INSA-GEI/afficheurs/BatterieMode_Ecran.png

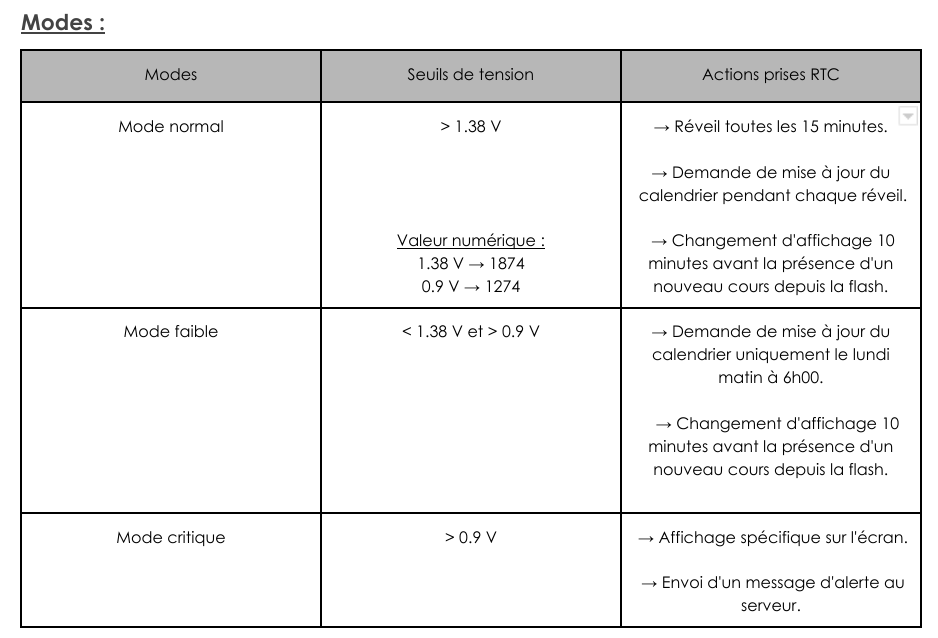
BatterieMode_Ecran.png
