INSA-GEI/afficheurs/Statechart_ecran.pdf

## TASK FIRST WAKE UP

## TASK INIT

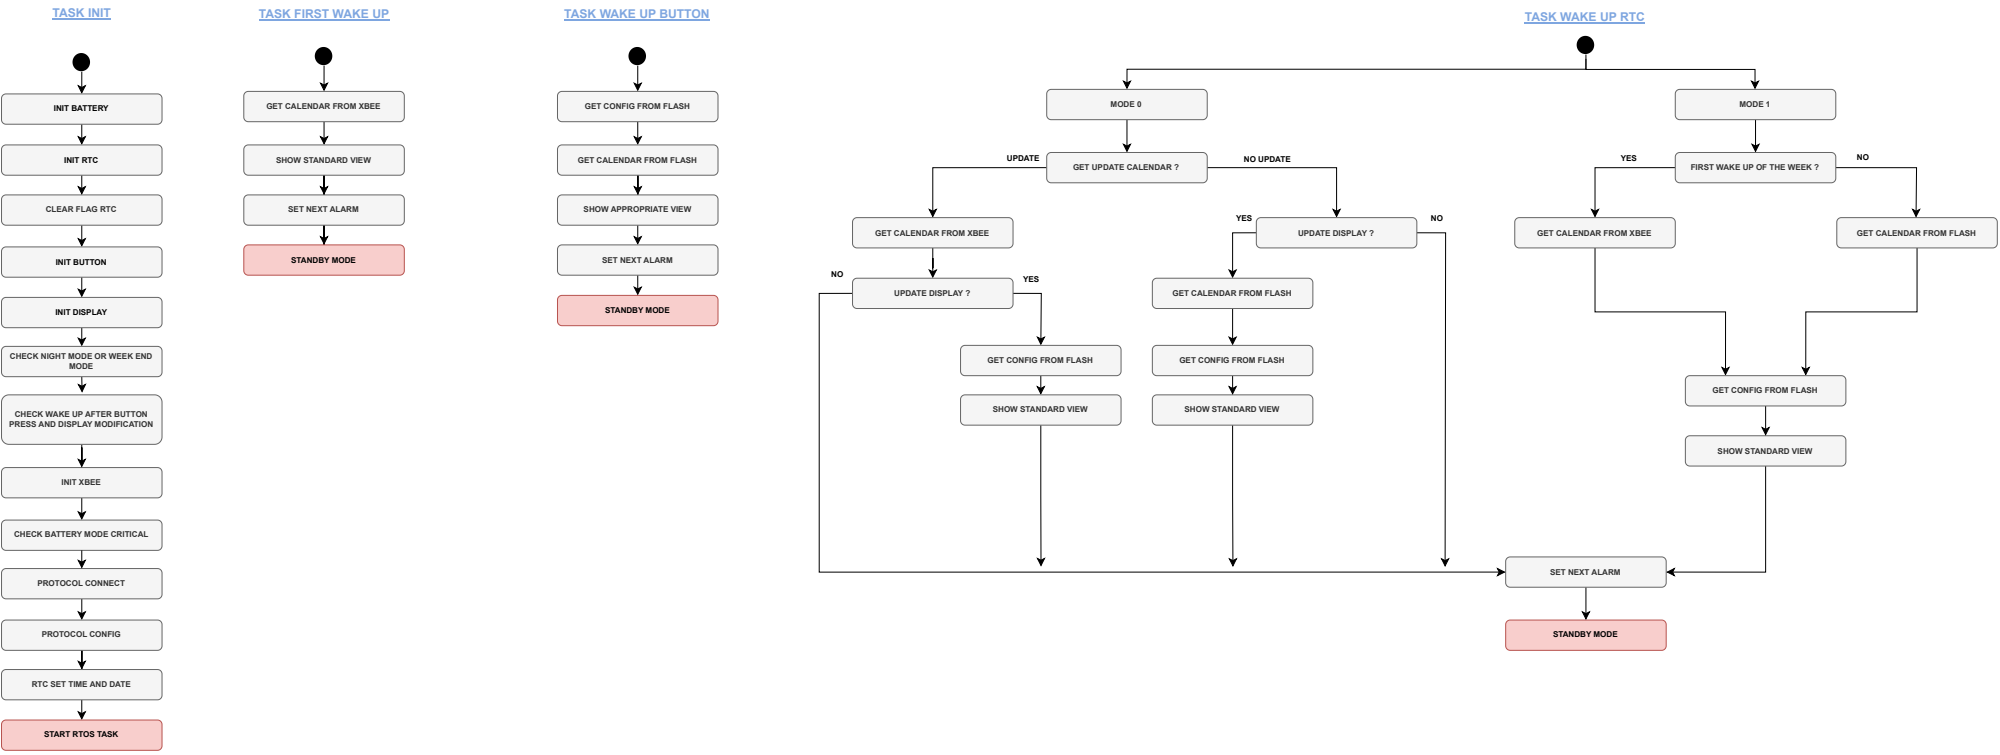
[picture p2: page 1]
INIT BATTERY; INIT RTC; INIT BUTTON; INIT DISPLAY; INIT XBEE; PROTOCOL CONNECT; PROTOCOL CONFIG; MODE; STANDBY MODE; MODE 0; NO UPDATE; MODE 1; UPDATE; YES NO; UPDATE DISPLAY ?; YES

TASK WAKE UP BUTTON

TASK WAKE UP RTC

GET CALENDAR FROM XBEE

GET CONFIG FROM FLASH

SHOW STANDARD VIEW

GET CALENDAR FROM FLASH

GET UPDATE CALENDAR ?

FIRST WAKE UP OF THE WEEK ?

CLEAR FLAG RTC

SET NEXT ALARM

SHOW APPROPRIATE VIEW

CHECK NIGHT MODE OR WEEK END

CHECK WAKE UP AFTER BUTTON
PRESS AND DISPLAY MODIFICATION

CHECK BATTERY MODE CRITICAL

RTC SET TIME AND DATE

START RTOS TASK
