INSA-GEI/afficheurs/hardware/pcb/board-v1/board-v1.kicad_pcb

## KiCad design hardware/pcb/board-v1/board-v1.kicad_pcb (2023-11-24)

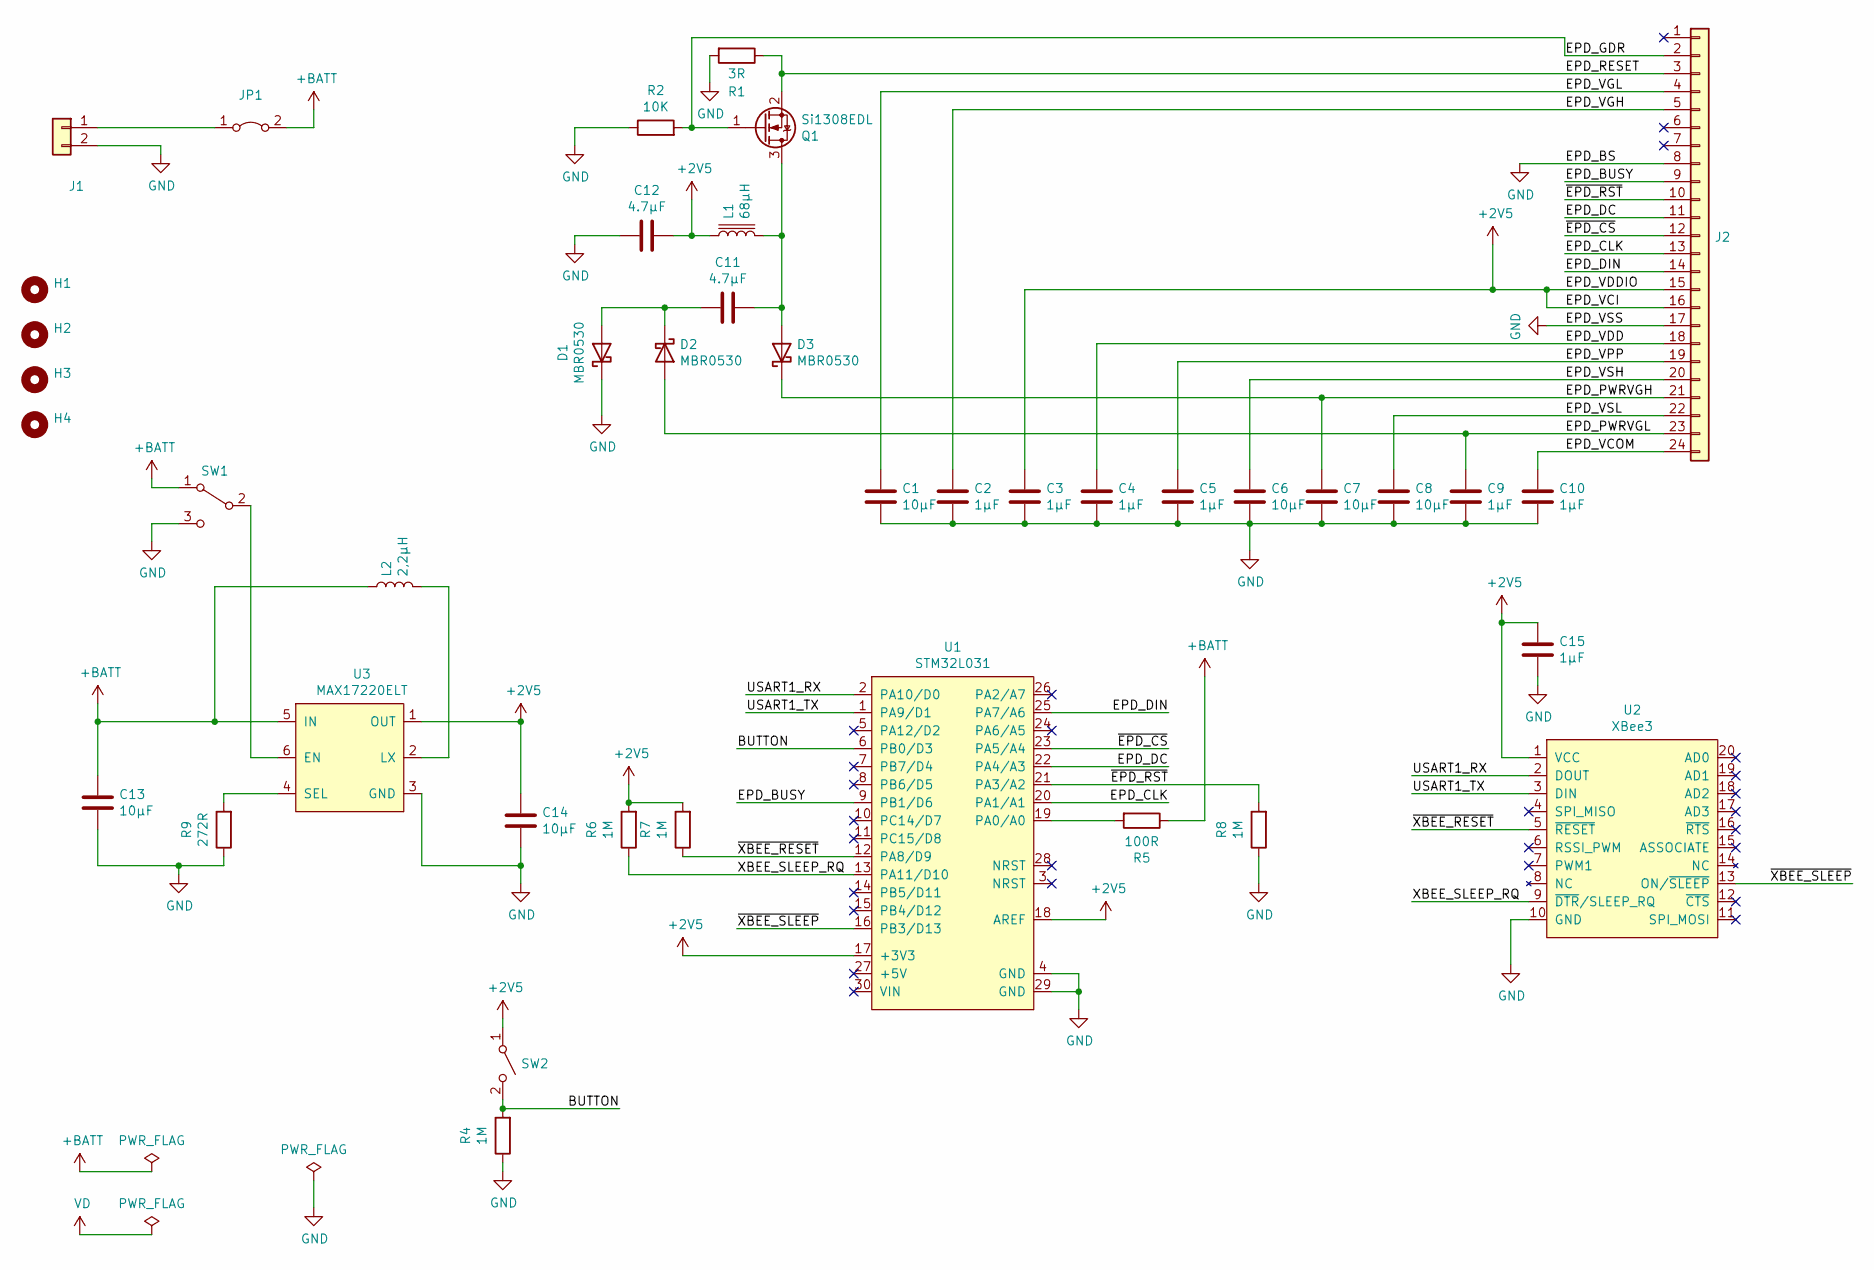
[picture p3: schematic board-v1.kicad_sch]

Parts:
C1, C6, C7, C8: 10µF; C_0603_1608Metric
C2, C3, C4, C5, C9, C10: 1µF; C_0603_1608Metric
C11, C12: 4.7µF; C_0603_1608Metric
C13, C14: 10µF; C_0805_2012Metric
C15: 1µF; C_0805_2012Metric
D1, D2, D3: MBR0530; D_TUMD2
H1, H2, H3, H4: MountingHole; MountingHole_3.2mm_M3
J1: Conn_01x02; PinHeader_1x02_P2.54mm_Vertical
J2: Conn_01x24; Hirose_FH12-24S-0.5SH_1x24-1MP_P0.50mm_Horizontal
JP1: Jumper_2_Bridged; SolderJumper-2_P1.3mm_Bridged_RoundedPad1.0x1.5mm
L1: 68µH; L_1210_3225Metric_Pad1.42x2.65mm_HandSolder
L2: 2,2µH; L_Wuerth_MAPI-4030
Q1: Si1308EDL; SOT-323_SC-70
R1: 3R; R_0603_1608Metric
R2: 10K; R_0603_1608Metric
R4, R6, R7, R8: 1M; R_0603_1608Metric
R5: 100R; R_0603_1608Metric
R9: 272R; R_0805_2012Metric
SW1: SW_SPDT; SW_Slide_1P2T_CK_OS102011MS2Q
SW2: SW_SPST; SW_Push_1P1T_NO_6x6mm_H9.5mm
U1: STM32L031; STM32-Nucleo-32
U2: XBee3; Xbee3
U3: MAX17220ELT; uDFN-6-1EP_2x2mm_P0.65mm_EP1x1.6mm

Connections:
+2V5: C3.1, C12.2, C14.1, C15.1, J2.15, J2.16, L1.1, R6.2, R7.2, SW2.1 (A), U1.17 (+3V3), U1.18 (AREF), U2.1 (VCC), U3.1 (OUT)
+BATT: C13.1, JP1.2 (B), L2.1, R5.1, SW1.1 (A), U3.5 (IN)
/BUTTON: R4.2, SW2.2 (B), U1.6 (PB0/D3)
/EPD_BUSY: J2.9, U1.9 (PB1/D6)
/EPD_CLK: J2.13, U1.20 (PA1/A1)
/EPD_DC: J2.11, U1.22 (PA4/A3)
/EPD_DIN: J2.14, U1.25 (PA7/A6)
/EPD_GDR: J2.2, Q1.1 (G), R2.2
/EPD_PWRVGH: C7.1, D3.1 (K), J2.21
/EPD_PWRVGL: C9.1, D2.2 (A), J2.23
/EPD_RESET: J2.3, Q1.2 (S), R1.1
/EPD_VCOM: C10.1, J2.24
/EPD_VDD: C4.1, J2.18
/EPD_VGH: C2.1, J2.5
/EPD_VGL: C1.1, J2.4
/EPD_VPP: C5.1, J2.19
/EPD_VSH: C6.1, J2.20
/EPD_VSL: C8.1, J2.22
/USART1_RX: U1.2 (PA10/D0), U2.2 (DOUT)
/USART1_TX: U1.1 (PA9/D1), U2.3 (DIN)
/XBEE_SLEEP_RQ: R6.1, U1.13 (PA11/D10), U2.9 (~DTR/SLEEP_RQ)
/~EPD_CS: J2.12, U1.23 (PA5/A4)
/~EPD_RST: J2.10, R8.2, U1.21 (PA3/A2)
/~XBEE_RESET: R7.1, U1.12 (PA8/D9), U2.5 (~RESET)
/~XBEE_SLEEP: U1.16 (PB3/D13), U2.13 (ON/~SLEEP)
GND: C1.2, C2.2, C3.2, C4.2, C5.2, C6.2, C7.2, C8.2, C9.2, C10.2, C12.1, C13.2, C14.2, C15.2, D1.1 (K), J1.2, J2.8, J2.17, R1.2, R2.1, R4.1, R8.1, R9.1, SW1.3 (C), U1.4 (GND), U1.29 (GND), U2.10 (GND), U3.3 (GND)
unnamed: C11.1, D1.2 (A), D2.1 (K)
unnamed: C11.2, D3.2 (A), L1.2, Q1.3 (D)
unnamed: J1.1, JP1.1 (A)
unnamed: L2.2, U3.2 (LX)
unnamed: R5.2, U1.19 (PA0/A0)
unnamed: R9.2, U3.4 (SEL)
unnamed: SW1.2 (B), U3.6 (EN)

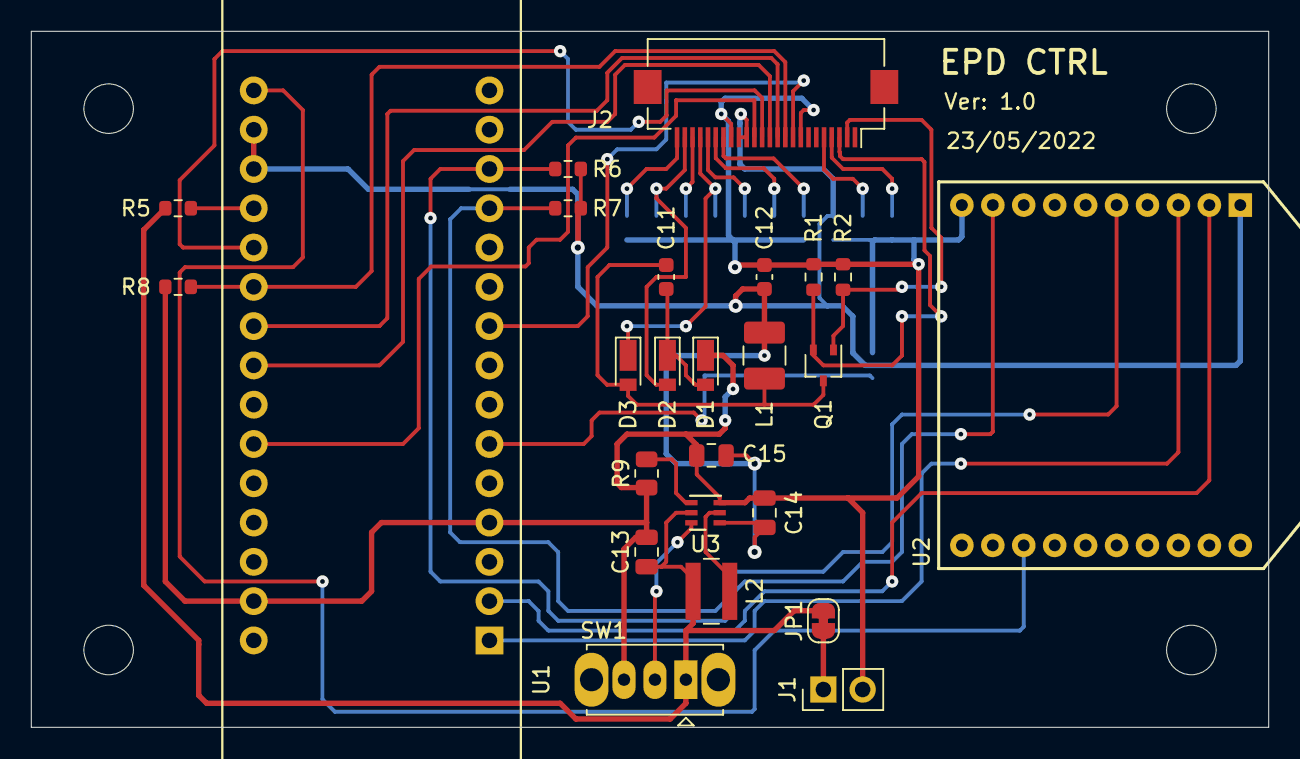
[picture p4: board board-v1.kicad_pcb from above]

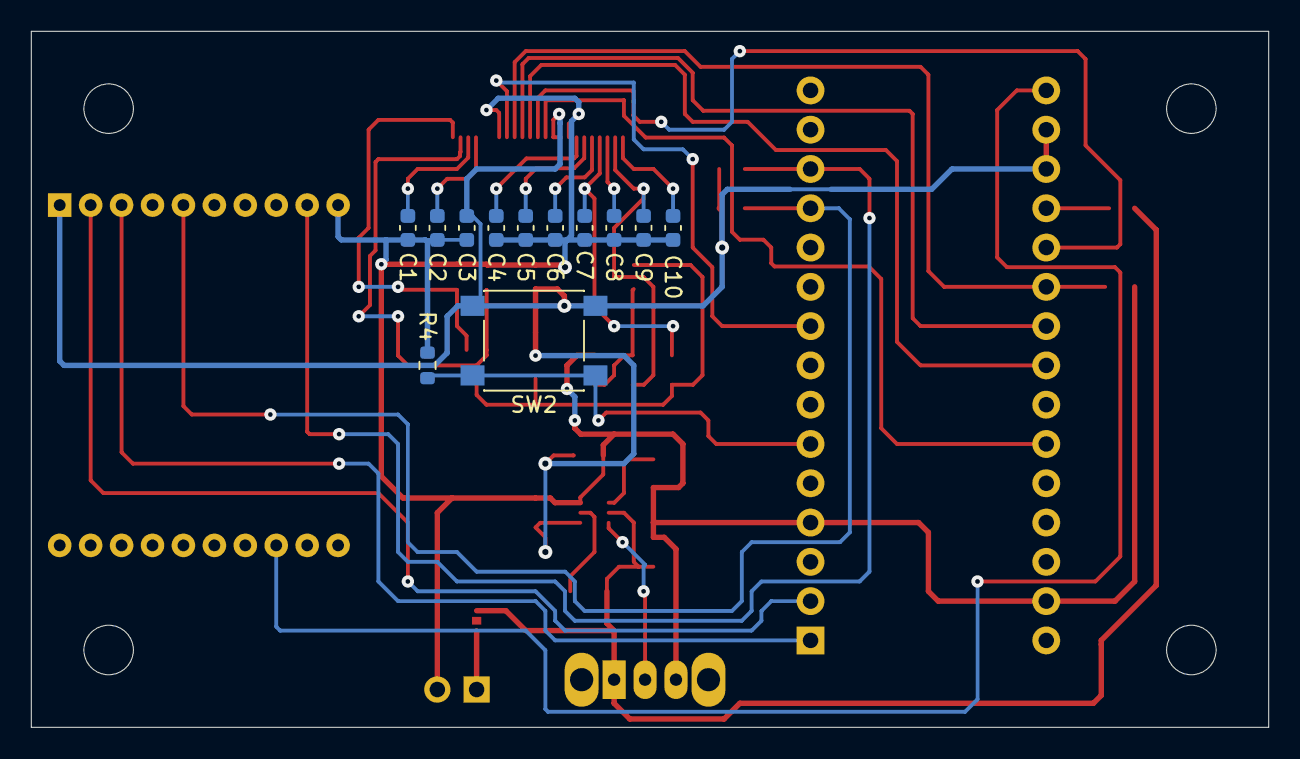
[picture p5: board board-v1.kicad_pcb from below]

Board: 2 copper layers, 80.0 x 45.0 mm, 41 parts (16 on the bottom side), 33 nets.
