INSA-GEI/afficheurs/hardware/pcb/Pi uHat Xbee3/Pi uHat Xbee.kicad_pcb

## KiCad design hardware/pcb/Pi uHat Xbee3/Pi uHat Xbee.kicad_pcb (2022-01-21)

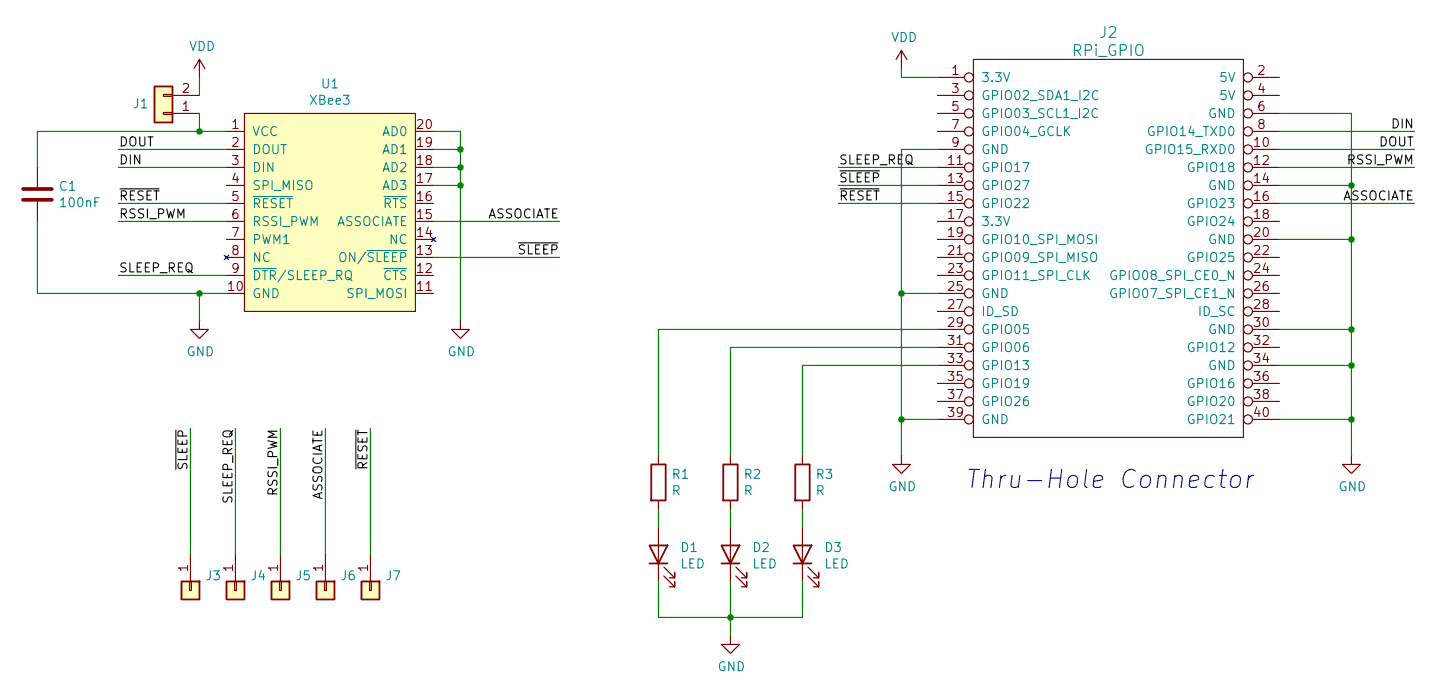
[picture p6: schematic Pi uHat Xbee.sch]

Parts:
C1: 100nF; C_1206_3216Metric_Pad1.33x1.80mm_HandSolder
D1, D2, D3: LED; LED_1206_3216Metric_Pad1.42x1.75mm_HandSolder
J1: Conn_01x02; PinHeader_1x02_P2.54mm_Vertical
J2: RPi_GPIO; PinHeader_2x20_P2.54mm_Vertical
J3, J4, J5, J6, J7: Conn_01x01; PinHeader_1x01_P2.54mm_Vertical
R1, R2, R3: R; R_1206_3216Metric_Pad1.30x1.75mm_HandSolder
U1: XBee3; Xbee3

Connections:
/ASSOCIATE: J2.16 (GPIO23), J6.1, U1.15 (ASSOCIATE)
/DIN: J2.8 (GPIO14_TXD0), U1.3 (DIN)
/DOUT: J2.10 (GPIO15_RXD0), U1.2 (DOUT)
/RSSI_PWM: J2.12 (GPIO18), J5.1, U1.6 (RSSI_PWM)
/SLEEP_REQ: J2.11 (GPIO17), J4.1, U1.9 (~DTR~/SLEEP_RQ)
/~RESET: J2.15 (GPIO22), J7.1, U1.5 (~RESET)
/~SLEEP: J2.13 (GPIO27), J3.1, U1.13 (ON/~SLEEP)
GND: C1.2, D1.1 (K), D2.1 (K), D3.1 (K), J2.6 (GND), J2.9 (GND), J2.14 (GND), J2.20 (GND), J2.25 (GND), J2.30 (GND), J2.34 (GND), J2.39 (GND), J2.40 (GPIO21), U1.10 (GND), U1.17 (AD3), U1.18 (AD2), U1.19 (AD1), U1.20 (AD0)
unnamed: C1.1, J1.1, U1.1 (VCC)
unnamed: D1.2 (A), R1.2
unnamed: D2.2 (A), R2.2
unnamed: D3.2 (A), R3.2
unnamed: J2.29 (GPIO05), R1.1
unnamed: J2.31 (GPIO06), R2.1
unnamed: J2.33 (GPIO13), R3.1
VDD: J1.2, J2.1 (3.3V)

Notes on the sheet:
Thru-Hole Connector

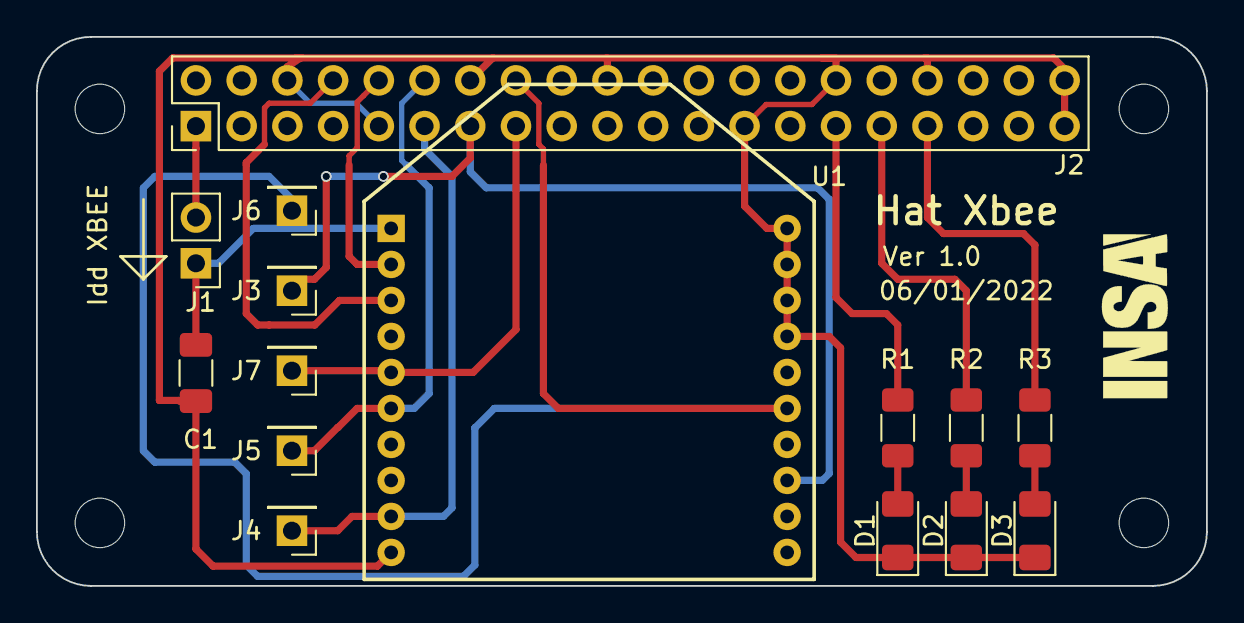
[picture p7: board Pi uHat Xbee.kicad_pcb from above]

Board: 2 copper layers, 65.0 x 30.5 mm, 15 parts (0 on the bottom side), 16 nets.
