INSA-GEI/afficheurs/software/firmware/Core/Src/main.c

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
/* Includes ------------------------------------------------------------------*/
//#include "main.h"
#include "stm32l4xx_hal.h"
#include "cmsis_os.h"
#include "config.h"

/* USER CODE BEGIN Includes */
#include "app.h"

/* USER CODE END Includes */

LPTIM_HandleTypeDef hlptim2;
UART_HandleTypeDef huart1;
UART_HandleTypeDef huart2;
DMA_HandleTypeDef hdma_usart1_rx;
DMA_HandleTypeDef hdma_usart1_tx;
DMA_HandleTypeDef hdma_memtomem_dma1_channel1;

/* USER CODE BEGIN PV */
RTC_HandleTypeDef hrtc;
uint8_t firstWakeUp;
uint8_t WakeUpButton;
uint8_t WakeUpRTC;
uint8_t WakeUpDebug;
/* USER CODE END PV */

void SystemClock_Config(void);
static void MX_USART2_UART_Init(void);
static void MX_DMA_Init(void);

/* USER CODE BEGIN PFP */
void who_wakeup_STM();
/* USER CODE END PFP */

/**
  * @brief  The application entry point.
  * @retval int
  */
int main(void)
{
  /* USER CODE BEGIN 1 */
  who_wakeup_STM();
  HAL_DeInit();
  /* USER CODE END 1 */

  /* MCU Configuration--------------------------------------------------------*/

  /* Reset of all peripherals, Initializes the Flash interface and the Systick. */
  HAL_Init();

  /* Configure the system clock */
  SystemClock_Config();

  /* Initialize all configured peripherals */
  MX_USART2_UART_Init();
  MX_DMA_Init();
  /* USER CODE BEGIN 2 */
  DEBUG_Init();
  /* USER CODE END 2 */

  /* Init scheduler */
  osKernelInitialize();

  /* USER CODE BEGIN RTOS_MUTEX */
  /* add mutexes, ... */
  /* USER CODE END RTOS_MUTEX */

  /* USER CODE BEGIN RTOS_SEMAPHORES */
  /* add semaphores, ... */
  /* USER CODE END RTOS_SEMAPHORES */

  /* USER CODE BEGIN RTOS_TIMERS */
  /* start timers, add new ones, ... */
  /* USER CODE END RTOS_TIMERS */

  /* USER CODE BEGIN RTOS_QUEUES */
  /* add queues, ... */
  /* USER CODE END RTOS_QUEUES */

  /* Create the thread(s) */
  /* creation of defaultTask */


  /* USER CODE BEGIN RTOS_THREADS */
  //APP_Init();

  TASKS_Create();
  TASKS_Run();
  /* USER CODE END RTOS_THREADS */

  /* USER CODE BEGIN RTOS_EVENTS */
  /* add events, ... */
  /* USER CODE END RTOS_EVENTS */

  /* Start scheduler */
  osKernelStart();

  /* We should never get here as control is now taken by the scheduler */
  /* Infinite loop */
  /* USER CODE BEGIN WHILE */

  while (1)
  {
    /* USER CODE END WHILE */

    /* USER CODE BEGIN 3 */
  }
  /* USER CODE END 3 */
}

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
/* USER CODE BEGIN 4 */
int __io_putchar(int ch)
{
	HAL_UART_Transmit(&huart2, (uint8_t*)&ch, 1, 500);

	return 1;
}

void who_wakeup_STM()
{
	    //Check Wakeup Flag
		firstWakeUp = !(__HAL_PWR_GET_FLAG(PWR_FLAG_SB));


		if(firstWakeUp == 1)
		{
			WakeUpButton = 0;
			WakeUpRTC = 0;
		}
		else if(__HAL_PWR_GET_FLAG(PWR_FLAG_WUF1) == 1)
		{
			WakeUpButton = 1;
		}
		else if(WakeUpButton == 0 && (__HAL_PWR_GET_FLAG(PWR_FLAG_WUFI)))
		{
			WakeUpRTC = 1;
		}
		else
		{
			WakeUpDebug = 1;
		}
}

/* USER CODE END 4 */
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
