INSA-GEI/afficheurs/software/firmware/door_display.ioc

Mcu.UserName=STM32L432KCUx
PA0.Signal=ADCx_IN5
PA1.Signal=SPI1_SCK
PA10.Signal=USART1_RX
PA11.GPIO_Label=XBEE_SLEEP_RQ
PA11.Signal=GPIO_Output
PA2.GPIO_Label=VCP_TX
PA2.Signal=USART2_TX
PA3.GPIO_Label=RST
PA3.Signal=GPIO_Output
PA4.GPIO_Label=DC
PA4.Signal=GPIO_Output
PA5.GPIO_Label=SPI_CS
PA5.Signal=GPIO_Output
PA7.Signal=SPI1_MOSI
PA8.GPIO_Label=XBEE_RESET
PA8.Signal=GPIO_Output
PA9.Signal=USART1_TX
PB0.GPIO_Label=BUTTON
PB0.Signal=GPXTI0
PB1.GPIO_Label=BUSY
PB1.Signal=GPXTI1
