INSA-GEI/afficheurs/software/firmware/Core/Inc/main.h

#define VCP_TX_Pin GPIO_PIN_2
#define VCP_TX_GPIO_Port GPIOA
#define RST_Pin GPIO_PIN_3
#define RST_GPIO_Port GPIOA
#define DC_Pin GPIO_PIN_4
#define DC_GPIO_Port GPIOA
#define SPI_CS_Pin GPIO_PIN_5
#define SPI_CS_GPIO_Port GPIOA
#define BUTTON_Pin GPIO_PIN_0
#define BUTTON_GPIO_Port GPIOB
#define BUTTON_EXTI_IRQn EXTI0_IRQn
#define BUSY_Pin GPIO_PIN_1
#define BUSY_GPIO_Port GPIOB
#define BUSY_EXTI_IRQn EXTI1_IRQn
#define XBEE_RESET_Pin GPIO_PIN_8
#define XBEE_RESET_GPIO_Port GPIOA
#define XBEE_SLEEP_RQ_Pin GPIO_PIN_11
#define XBEE_SLEEP_RQ_GPIO_Port GPIOA
#define SWDIO_Pin GPIO_PIN_13
#define SWDIO_GPIO_Port GPIOA
#define SWCLK_Pin GPIO_PIN_14
#define SWCLK_GPIO_Port GPIOA
#define VCP_RX_Pin GPIO_PIN_15
#define VCP_RX_GPIO_Port GPIOA
#define XBEE_SLEEP_Pin GPIO_PIN_3
#define XBEE_SLEEP_GPIO_Port GPIOB
#define XBEE_SLEEP_EXTI_IRQn EXTI3_IRQn
