INSA-GEI/afficheurs/software/firmware/App/app.h

/*
 * *****************************************
 * *****************************************
 */

#ifndef APP_H_
#define APP_H_

#include "stm32l4xx_hal.h"
#include "config.h"

void TASKS_Create(void);
void TASKS_Run(void);

#endif /* APP_H_ */
