INSA-GEI/afficheurs/software/firmware/App/panic.h

/*
 * panic.h
 *
 *  Created on: 11 avr. 2022
 *      Author: dimercur
 */

#ifndef PANIC_H_
#define PANIC_H_

#include "stm32l4xx_hal.h"
#include "config.h"

typedef enum {
	PANIC_EVT_XBEE_CONFIG_ERROR=1,
	PANIC_EVT_DISPLAY_CONFIG_ERROR,
	PANIC_EVT_RTC_CONFIG_ERROR,
	PANIC_EVT_RTC_MSP_CONFIG_ERROR,
	PANIC_EVT_ADC_CONFIG_ERROR,
	PANIC_EVT_ADC_MSP_CONFIG_ERROR,
	PANIC_EVT_WAKE_UP,
	PANIC_EVT_SHOW_LASTED_CONFIGURATION,
	PANIC_EVT_CALENDER_UPDATE,
	PANIC_EVT_FLASH
} PANIC_Events;

void PANIC_Handler(PANIC_Events event);

#endif /* PANIC_H_ */
