INSA-GEI/afficheurs/(commit log)

2021-12-10 l'ecran fonctionne
    [Pi uHat Xbee.kicad_pcb, Pi uHat Xbee.sch, Xbee-868SL-Adapter.kicad_pcb, Xbee-868SL-Adapter.sch]
2021-12-14 Reorganisation repertoire + portage des fonts sur systeme lvgl
2021-12-14 Ajout d'icone, suppression de fichiers inutile
2021-12-14 Agrandissement de l'espace entre caracter de 1 pixel à 2
2022-01-05 ajout de la carte d'evaluation
    [eval-board.kicad_pcb, eval-board.sch]
2022-01-05 etape intermediaire
    [eval-board.kicad_pcb, eval-board.sch]
2022-01-06 Carte eval finie
    [eval-board.kicad_pcb, eval-board.sch]
2022-01-06 Hat Pi Wbee fini
    [Pi uHat Xbee.kicad_pcb, Pi uHat Xbee.sch]
2022-01-10 correction d'un bug dans la gestion des report
2022-01-21 reorganisation de l'arborescence + renommage serveré
    [Pi uHat Xbee.kicad_pcb, Portée Xbee.xlsx, Xbee-868SL-Adapter.kicad_pcb, Xbee-868SL-Adapter.sch, eval-board.kicad_pcb, eval-board.sch]
2022-01-31 reprise du code, ajout de la gestion reseau des gateways
2022-02-15 evolution de la classe decoded_frame en multiple classe, chacune pour un message
2022-02-16 ajout de la class networkmgr et messages, a debugger
2022-02-18 Simplification du systeme des messages
2022-03-03 Premiere version fonctionnelle de la gateway. Besoin de rajouter le support des commandes AT pour la configuration du Xbee
2022-03-03 Gestion des commandes AT en cours
2022-03-28 Basculement sur la methode getEvents plutot que getactivities pour la recuperation du calendrier
2022-03-30 Recuperation des infos ADE et tri OK
2022-03-30 Ajout d'un systeme de dictionnaire + nettoyage de code
2022-03-31 reponses aux commande a peu pres correctes, reste le timer pour la commande JOIN
2022-04-04 Version de gateway et de server suffisament fonctionnels pour etre utilisés
2022-04-06 Debug driver XBEE
2022-04-12 Driver xbee a peu pres ok
2022-04-15 Timeout ajouté dans xbee_ll, scan de canaux et connection au reseau OK
2022-04-20 preparation du test pour la recuperation des calendriers
2022-04-25 Recuperation de calendrier OK, timeout a rajouter, et verifier les strncpy (à remplacer par memcpy)
2022-04-29 ajout des drivers adc, exti et rtc, a debugger
2022-05-06 Passage sous Freertos pour battery,rtc et button
2022-05-11 Tous les drivers sont passé au format freertos, mais l'ecran ne marche plus et le Xbee n'est pas testé. Les autres peripheriques semblent marcher
2022-05-13 xbee marche, ecran marche, affiche des premieres infos
2023-01-09 dernier commit avant changement de branche
    [board-v1.csv, board-v1.kicad_pcb, board-v1.kicad_sch, board-v1.sch]
2023-11-24 Fin de stage
2023-11-24 Nettoyage de l'arboresence avant debut des travaux
2023-11-28 Transfert de la consultation depuis l'API ADE vers des scripts CSN
2023-12-11 Prise en charge des commandes Zigbee partielle
